sevvalmehder/RaspiJoy/Presentations/SevvalMEHDER-495-SonSunum.pdf

Bilgisayar Mühendisliği Bölümü

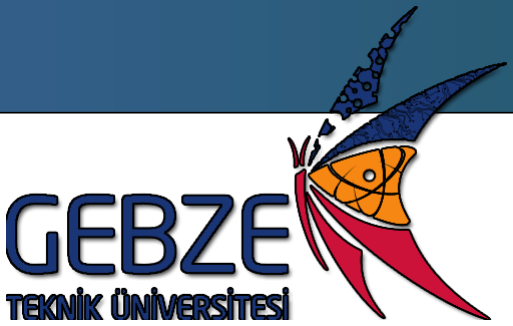
[picture p27: figure]

# RASPIJOY Uçuş Simülatörü için Kumanda

CSE 495
Son Sunum

Şevval MEHDER

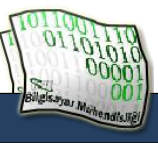
[picture p28: figure]

Proje Danışmanı: Prof. Dr. Erkan ZERGEROĞLU Ocak 2019

GTÜ - Bilgisayar Mühendisliği Bölümü | BİL 495/496 Bitirme Projesi | 2

## - Proje Tanımı

## - İzlenen Yol

## - Yapılanlar

## - Başarı Kriterlerinin Kontrolü

## - RaspiJoy’un farklı joystick olarak çalışması

## - Kaynaklar

# İçerik

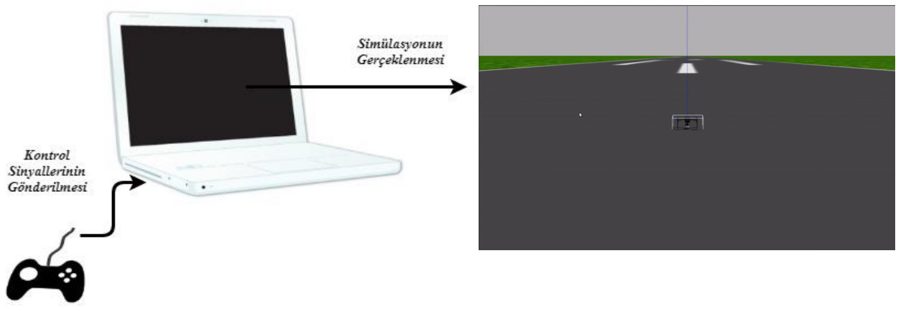
[picture p29: figure]

GTÜ - Bilgisayar Mühendisliği Bölümü | BİL 495/496 Bitirme Projesi | 3

# Proje Tanımı

Uçuş simülasyon programı SITL ve 3 boyutlu simülasyon programı Gazebo için Raspberry Pi Zero kullanılarak düşük maliyetli bir kumanda yapılması

# İzlenen yol

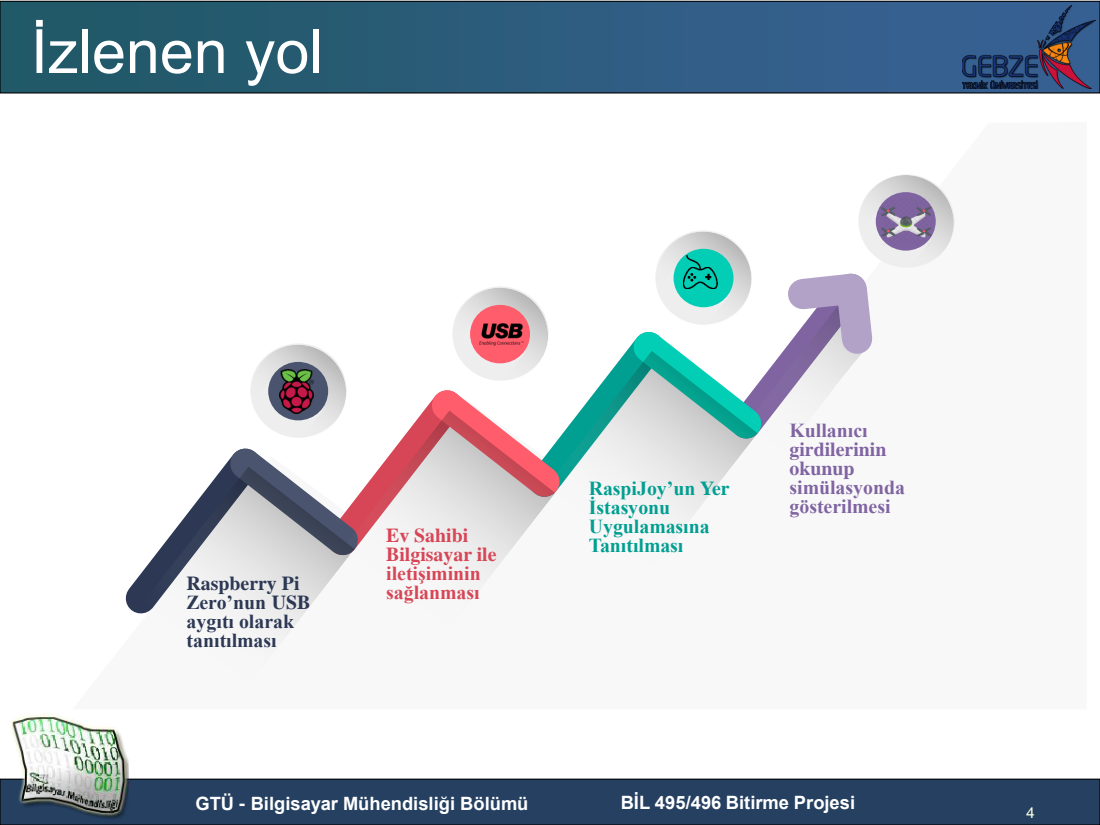
[picture p30: page 4]
GTÜ - Bilgisayar Mühendisliği Bölümü; BİL 495/496 Bitirme Projesi; Ev Sahibi Bilgisayar ile iletişiminin sağlanması; Kullanıcı girdilerinin okunup simülasyonda gösterilmesi

RaspiJoy’un Yer
İstasyonu
Uygulamasına
Tanıtılması

Raspberry Pi
Zero’nun USB
aygıtı olarak
tanıtılması

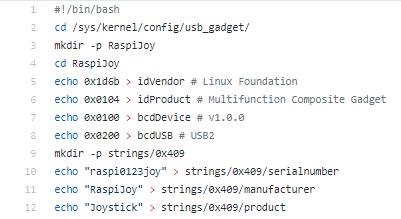
[picture p31: figure]

GTÜ - Bilgisayar Mühendisliği Bölümü | BİL 495/496 Bitirme Projesi

## Pi Zero’nun USB Aygıtı Olarak Tanıtılması

Configfs ismi verilen dosya sisteminin sağladığı arayüz sayesinde kullanıcıya özel USB aygıt tanımlaması yapıldı.

Üretici kimliği ve adı, ürünün adı, seri numarası, fonksiyonları, üreteceği bilginin türü ve boyutu gibi birçok özelliği tanımlandı.

## Pi Zero’nun USB Aygıtı Olarak Tanıtılması

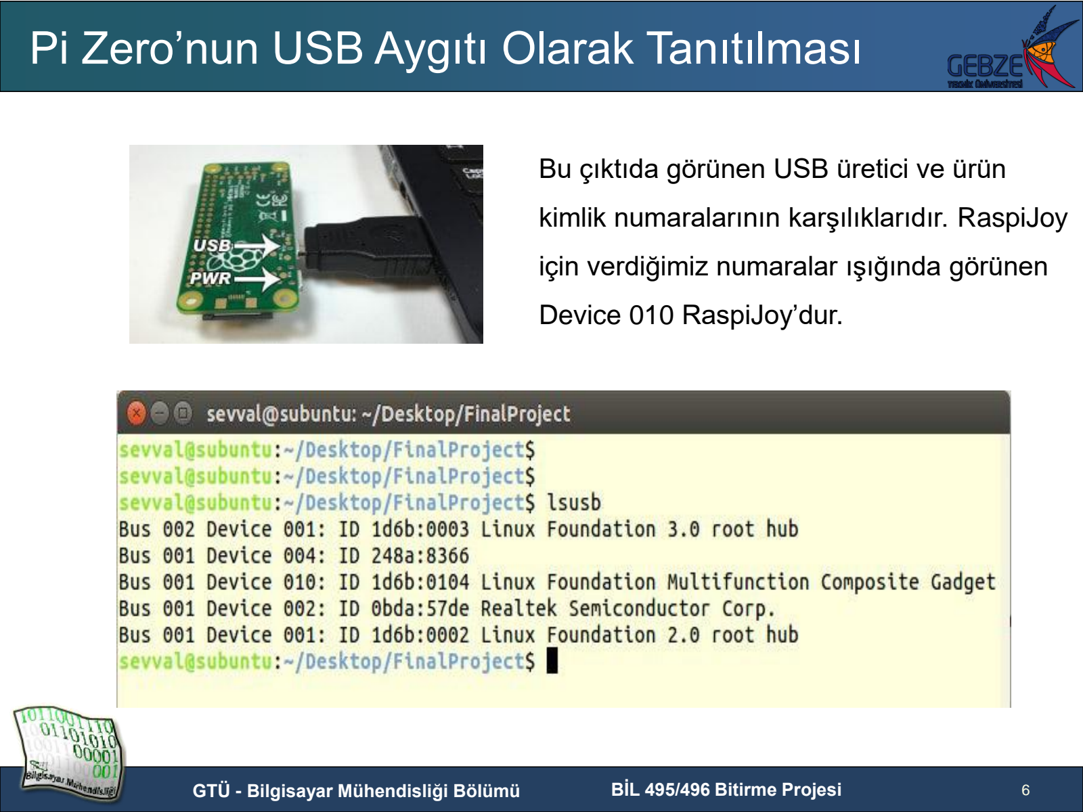
[picture p32: page 6]

6

Bu çıktıda görünen USB üretici ve ürün

kimlik numaralarının karşılıklarıdır. RaspiJoy

için verdiğimiz numaralar ışığında görünen

Device 010 RaspiJoy’dur.

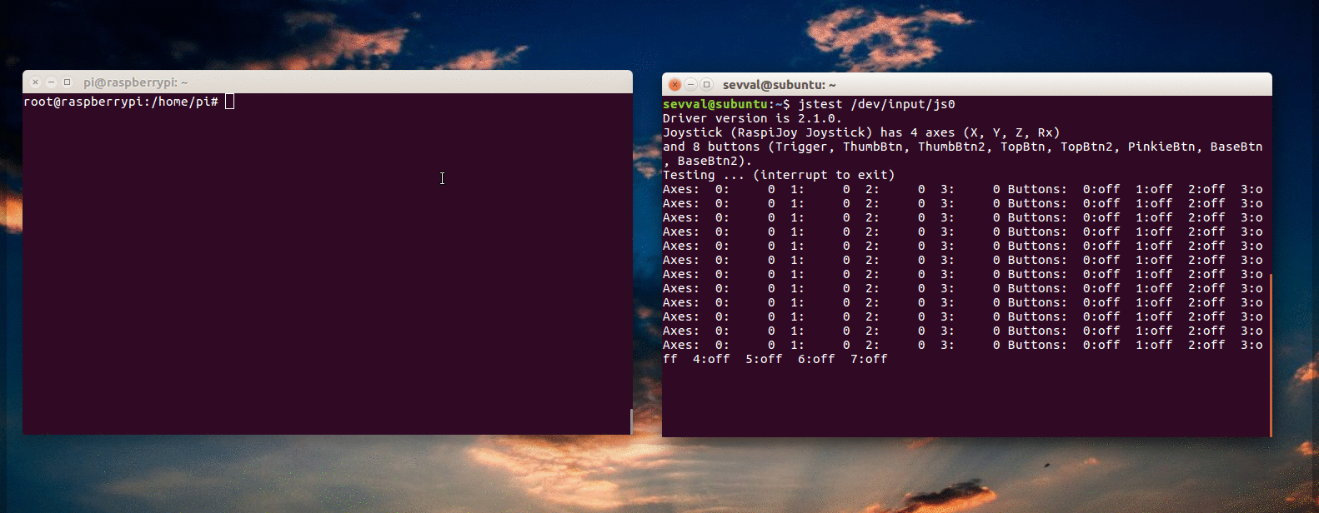
[picture p33: figure]

GTÜ - Bilgisayar Mühendisliği Bölümü | BİL 495/496 Bitirme Projesi | 7

## Ev Sahibi Bilgisayar ile İletişimin Sağlanması

RaspiJoy’un bilgisayar tarafında haberleşeceği sürücü usbhid sürücüdür. Bu sürücü Linux’un HID sınıfı aygıtlar için atadığı bir sürücüdür.

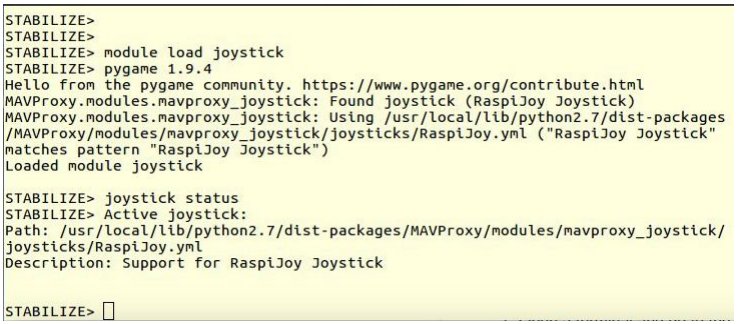
[picture p34: figure]

GTÜ - Bilgisayar Mühendisliği Bölümü | BİL 495/496 Bitirme Projesi | 8

## RaspiJoy’un Yer İstasyonu’na Tanıtılması

MAVProxy joystick modülü klasöründe MAVProxy tarafından tanınan joystick’lerin hangi hareketin simülasyonda hangi kanaldaki değeri değiştireceğinin anlatıldığı tanımları YAML formatında saklanır ve simülasyon sırasında bu tanımlar yüklenir. RaspiJoy 3 temel kontrol ile 6 kanalı kontrol eder:
1. Eksenler
2. Butonlar
3. Çoklu Buton

## Kullanıcı Girdilerinin Okunup Simülasyonda Gösterilmesi

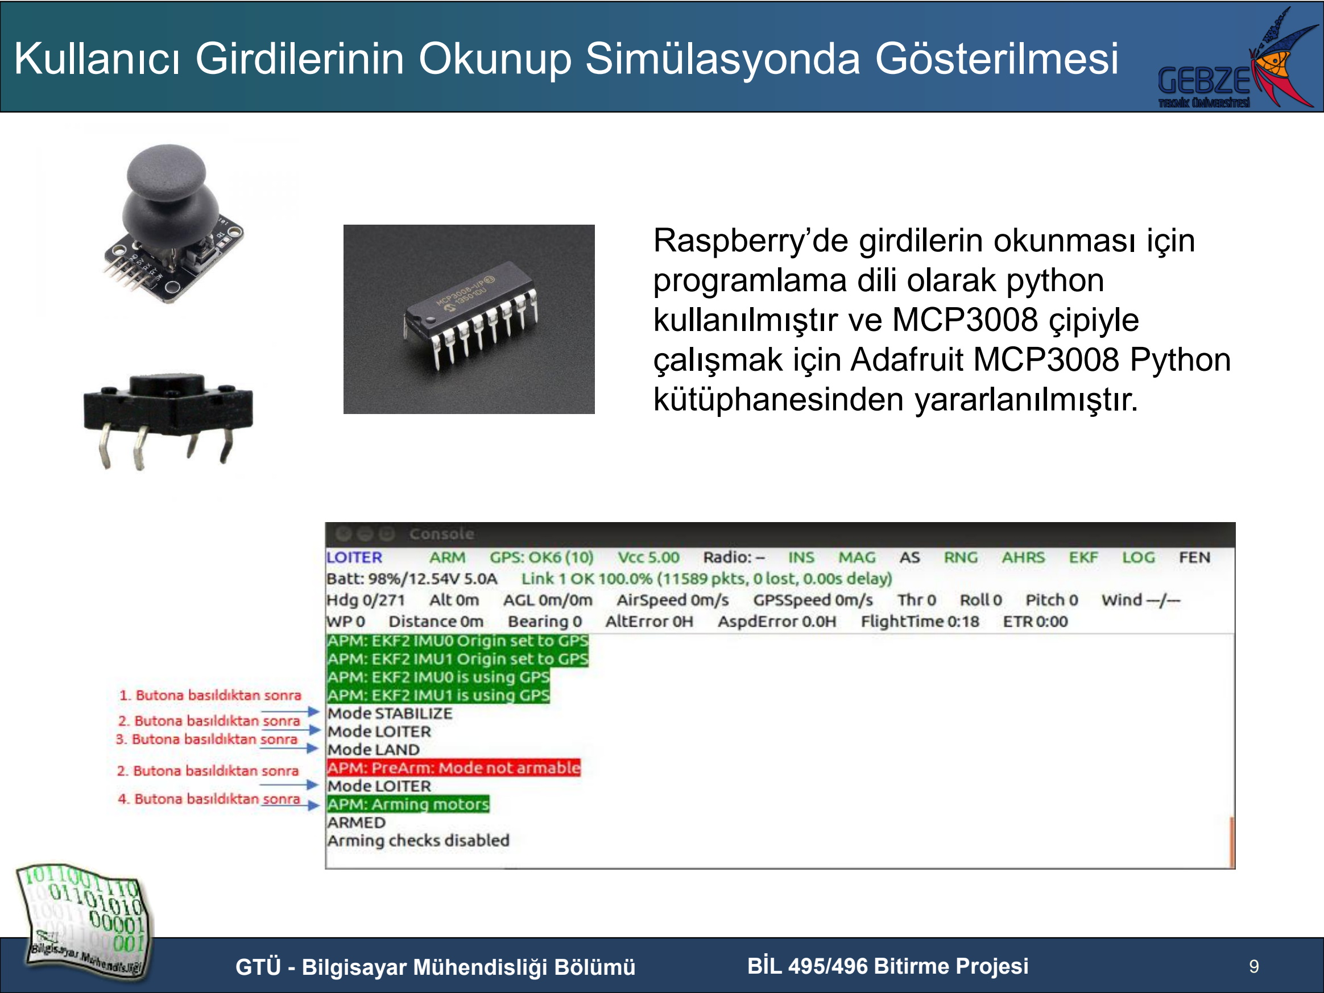
[picture p35: page 9]

GTÜ - Bilgisayar Mühendisliği Bölümü | BİL 495/496 Bitirme Projesi | 9

Raspberry’de girdilerin okunması için programlama dili olarak python kullanılmıştır ve MCP3008 çipiyle çalışmak için Adafruit MCP3008 Python kütüphanesinden yararlanılmıştır.

# Başarı Kriterlerinin Kontrolü

## Nicel gözlemler sonucu:

1. Simülasyondaki hareketin, kontrol sinyaliyle aynı olması
2. Gecikme süresi < 50 ms olması

## Nitel gözlemler sonucu:

1. Açık Kaynak Yazılım Topluluğu tarafından kabul edilebilir ve kullanılabilir olması

# Başarı Kriterlerinin Kontrolü

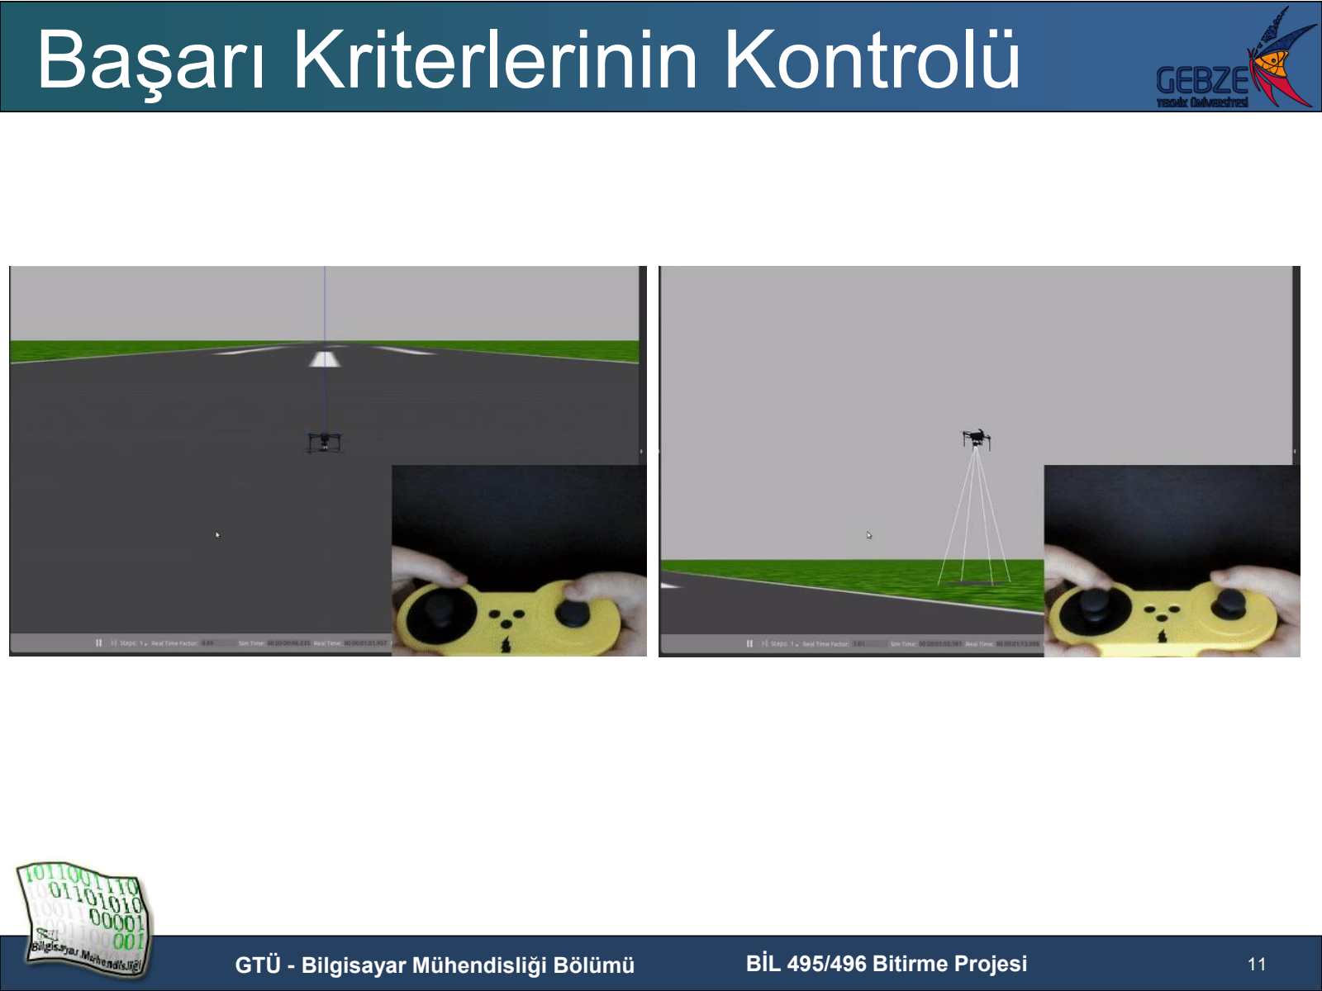
[picture p36: page 11]

GTÜ - Bilgisayar Mühendisliği Bölümü | BİL 495/496 Bitirme Projesi | 11

# Başarı Kriterlerinin Kontrolü

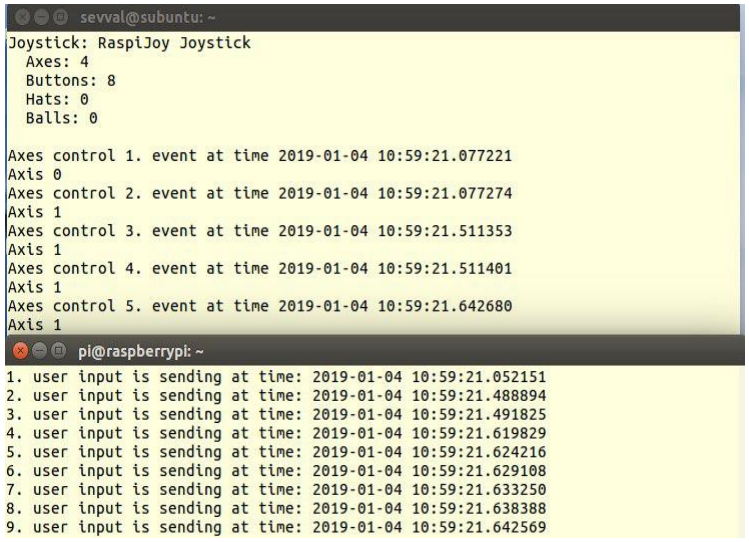
[picture p37: figure]

- Piyasadaki birçok kumanda markasındaki gecikmeleri
ölçen ve sonuçları sunan
bir yazıya göre en fazla 42 milisaniyelik bir gecikme
ölçüldüğü için başarı
kriterinde gecikmenin 50
milisaniyeden az olması
planlanmıştır.
- Farklı zamanlarda yapılan birkaç test sonucu olarak
ortalama gecikme süresi 26 milisaniyedir

## RaspiJoy’un farklı joystick olarak çalışması

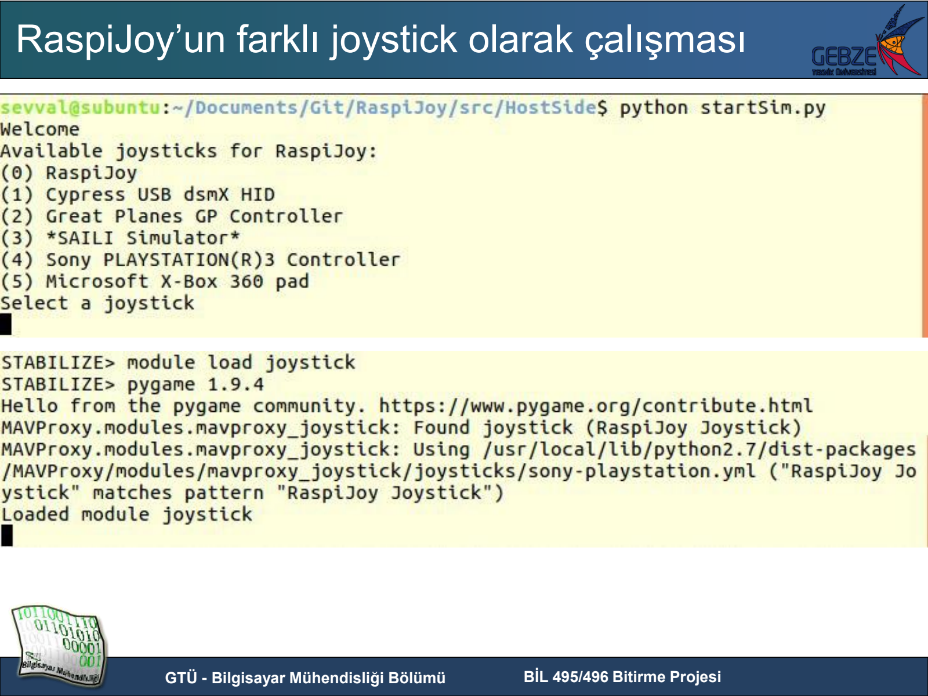
[picture p38: page 13]

## RaspiJoy’un farklı joystick olarak çalışması

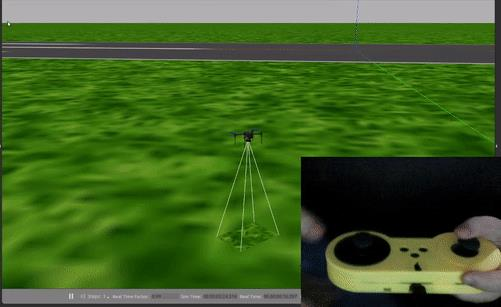
[picture p39: figure]

# Kaynaklar

1. Matt Porter Linaro, Kernel USB Gadget Configfs Interface [online], https://events.static.linuxfound.org/sites/events/files/slides/USB%20Gadget%20Configfs%20API_0.pdf (https://events.static.linuxfound.org/sites/events/files/slides/USB%20Gadget%20Configfs%20API_0.pdf)
2. Microsoft Word - HID1_11.doc [online], https://www.usb.org/sites/default/files/documents/hid1_11.pdf. [Ziyaret Tarihi: 23
Kasım 2018]
3. Arcade Stick Input Lag – Results [online], http://www.teyah.net/sticklag/results.html
4. ArduPilot Copter Home[online], http://ardupilot.org/copter/

15
