sevvalmehder/RaspiJoy/Presentations/SevvalMEHDER-495-İkinciİzleme.pdf

Bilgisayar Mühendisliği Bölümü

# Uçuş Simülatörü için Joystick Arayüzü

## BIL 495 2. İzleme

## Şevval MEHDER


## Proje Danışmanı: Prof. Dr. Erkan ZERGEROĞLU

## Aralık 2018

GTÜ - Bilgisayar Mühendisliği Bölümü | BİL 495/496 Bitirme Projesi | 2

# - Projenin Şeması ve Tanımı

# - Proje Tasarım Planı

# - Yapılanlar

# - Yapılacaklar

# - Kaynaklar

# İçerik

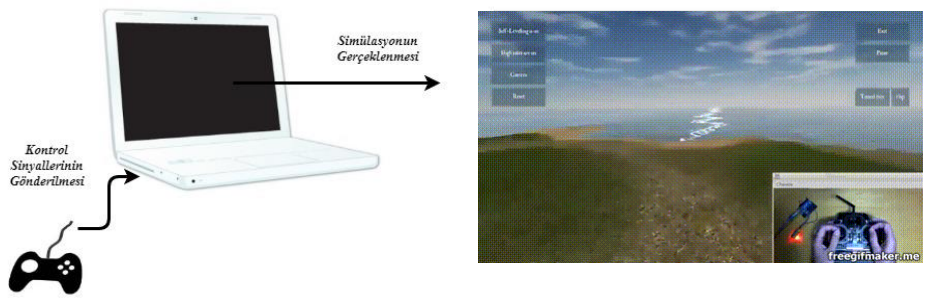
[picture p40: figure]

GTÜ - Bilgisayar Mühendisliği Bölümü | BİL 495/496 Bitirme Projesi | 3

# Proje Şeması ve Tanımı

## − ArduPilot Simülasyon Programı için bir joystick

donanımı ve arayüz hazırlanması.

# Yapılanlar

Raspberry Pi Zero’nun USB aygıtı olarak tanınması desteği sağlandı.

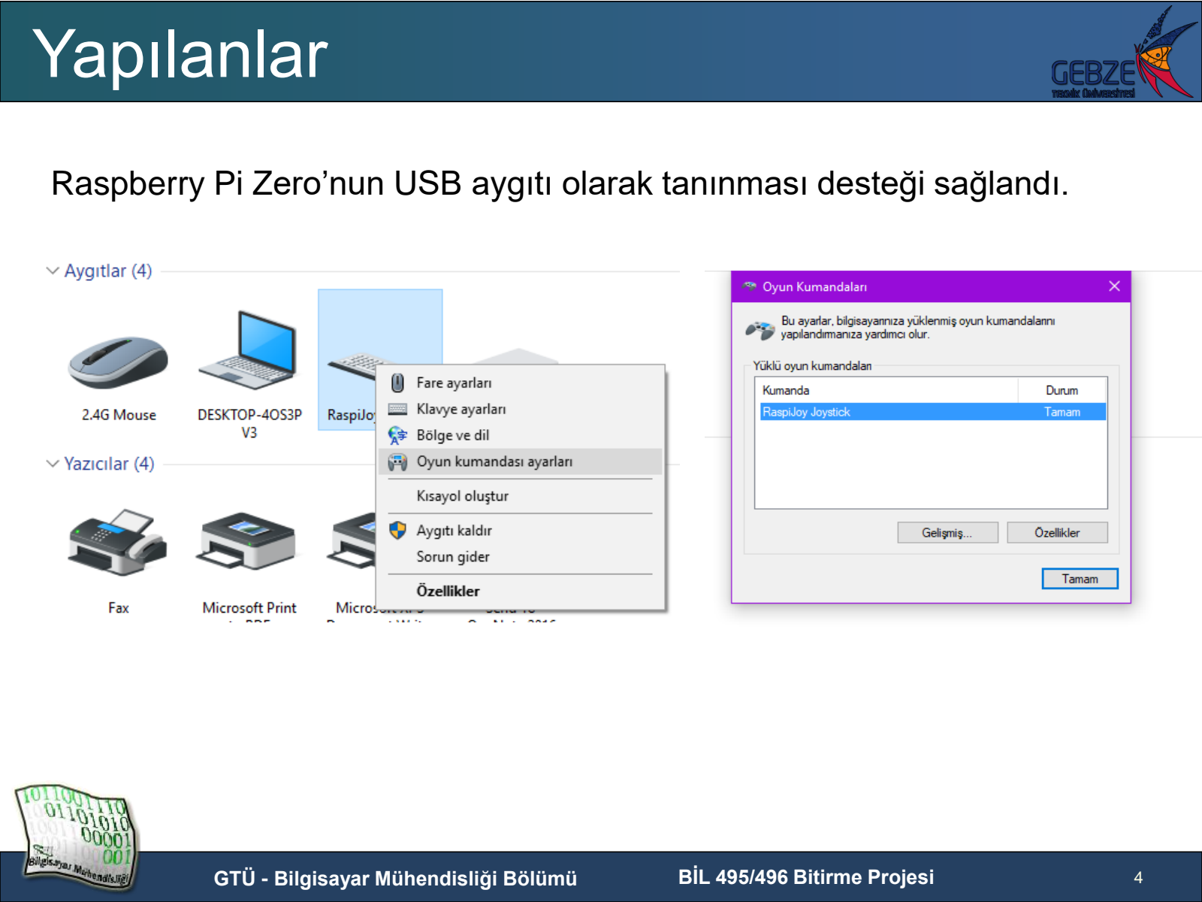
[picture p41: page 4]

GTÜ - Bilgisayar Mühendisliği Bölümü | BİL 495/496 Bitirme Projesi | 4

# Yapılanlar

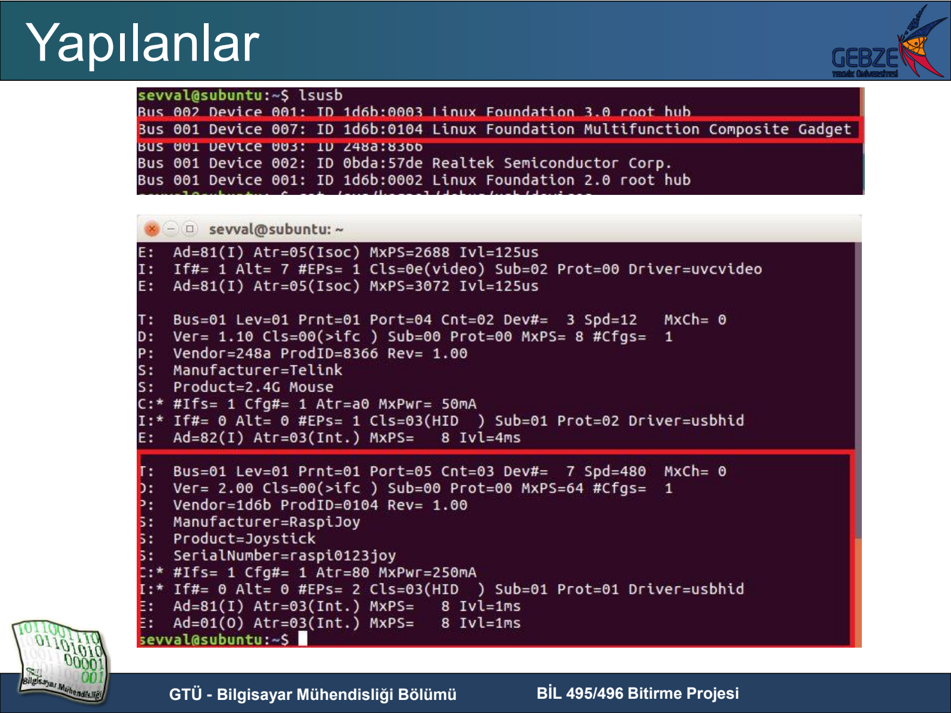
[picture p42: page 5]

GTÜ - Bilgisayar Mühendisliği Bölümü | BİL 495/496 Bitirme Projesi

# Yapılanlar

# USB konfigürasyon dosyasının yazılması

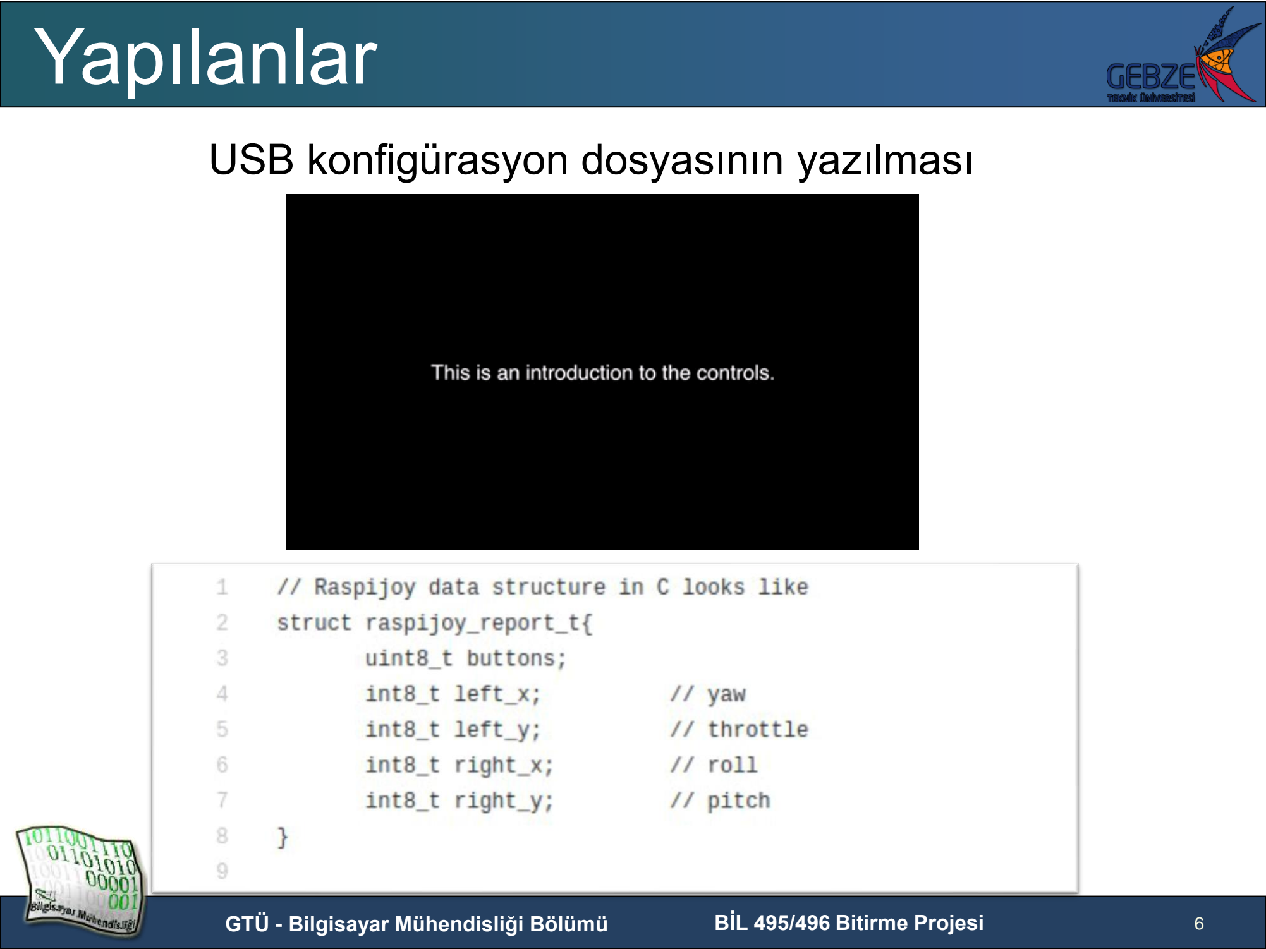
[picture p43: page 6]

GTÜ - Bilgisayar Mühendisliği Bölümü | BİL 495/496 Bitirme Projesi
6

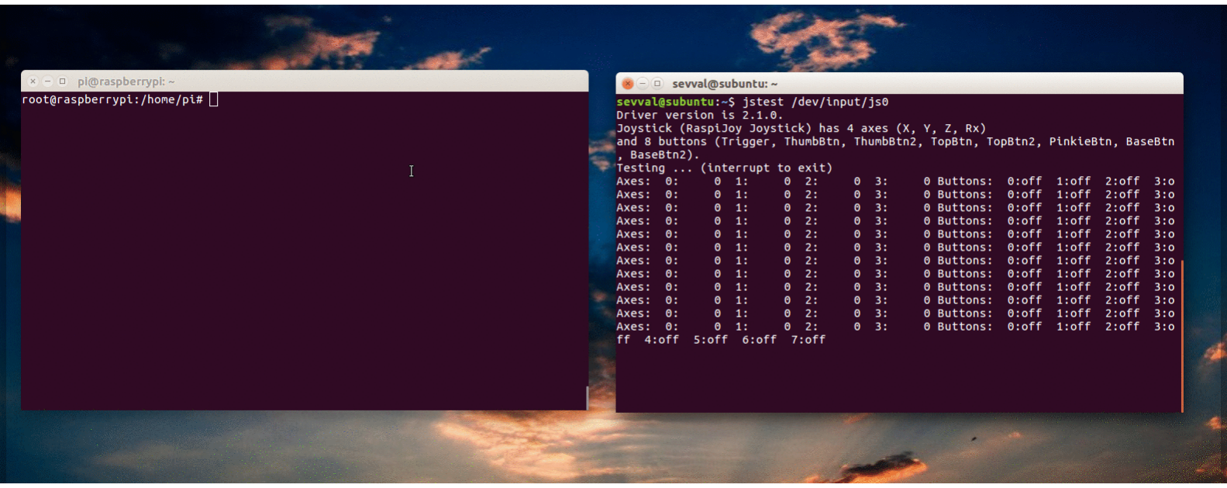
[picture p44: figure]

GTÜ - Bilgisayar Mühendisliği Bölümü | BİL 495/496 Bitirme Projesi | 7

# Yapılanlar

## Bilgisayara veri gönderilmesinin sağlanması

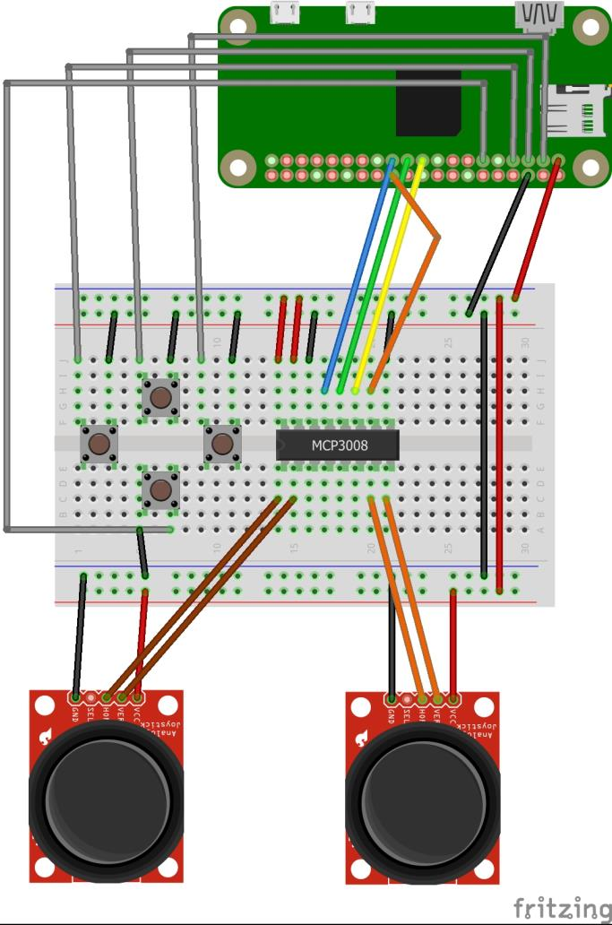
[picture p45: figure]

GTÜ - Bilgisayar Mühendisliği Bölümü | BİL 495/496 Bitirme Projesi | 8

# Yapılanlar

## Analog joystick modüllerinin ADC(MCP3008 chip) yardımıyla Raspberry’e bağlanması

# Yapılanlar

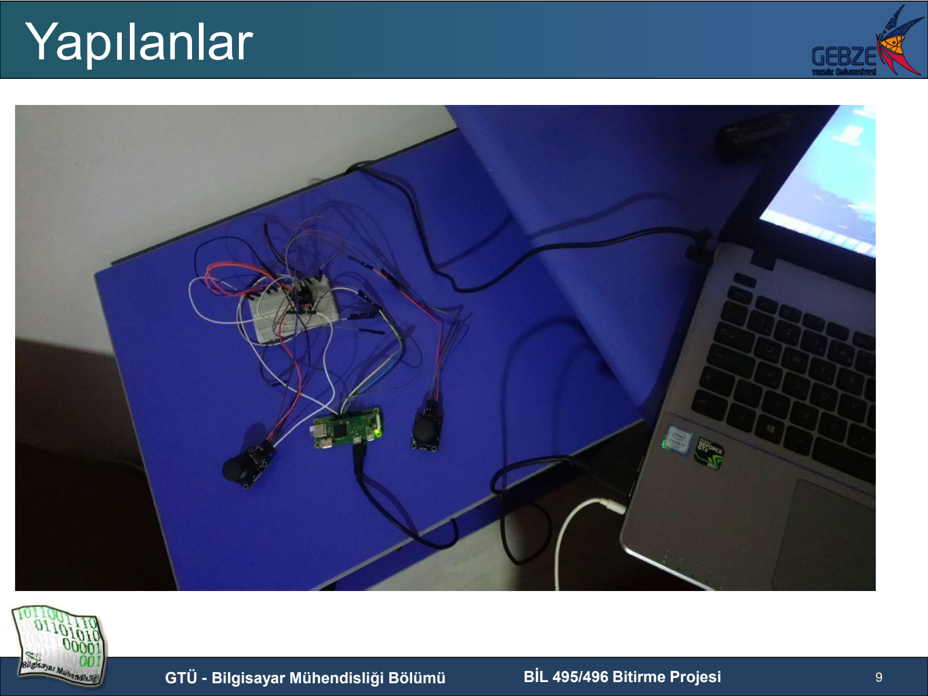
[picture p46: page 9]

GTÜ - Bilgisayar Mühendisliği Bölümü | BİL 495/496 Bitirme Projesi | 9

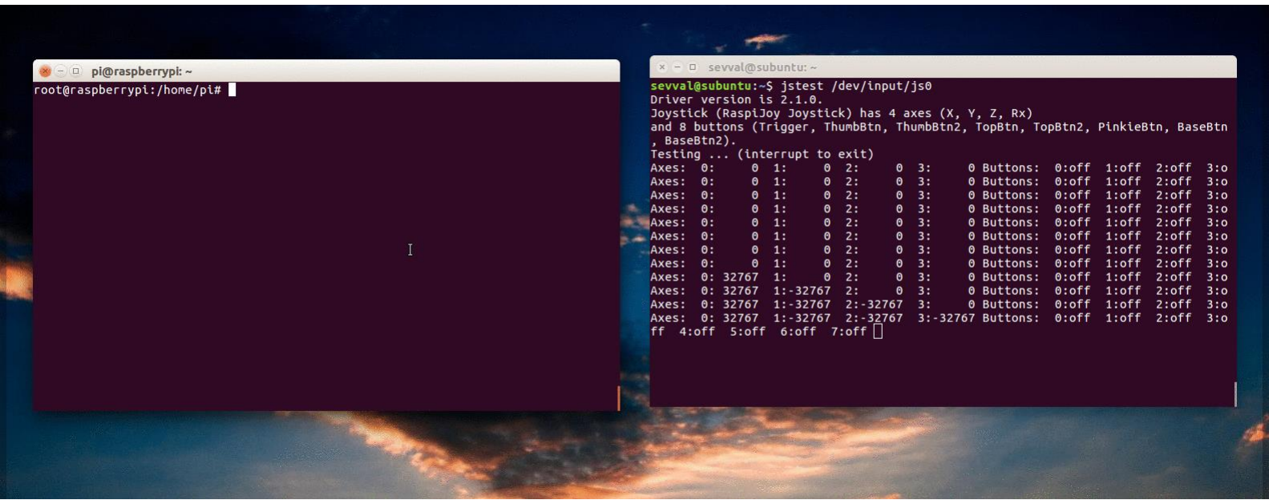
[picture p47: figure]

GTÜ - Bilgisayar Mühendisliği Bölümü | BİL 495/496 Bitirme Projesi | 10

# Yapılanlar

## Joystick modüllerinden gelen bilginin bilgisayara gönderilmesi

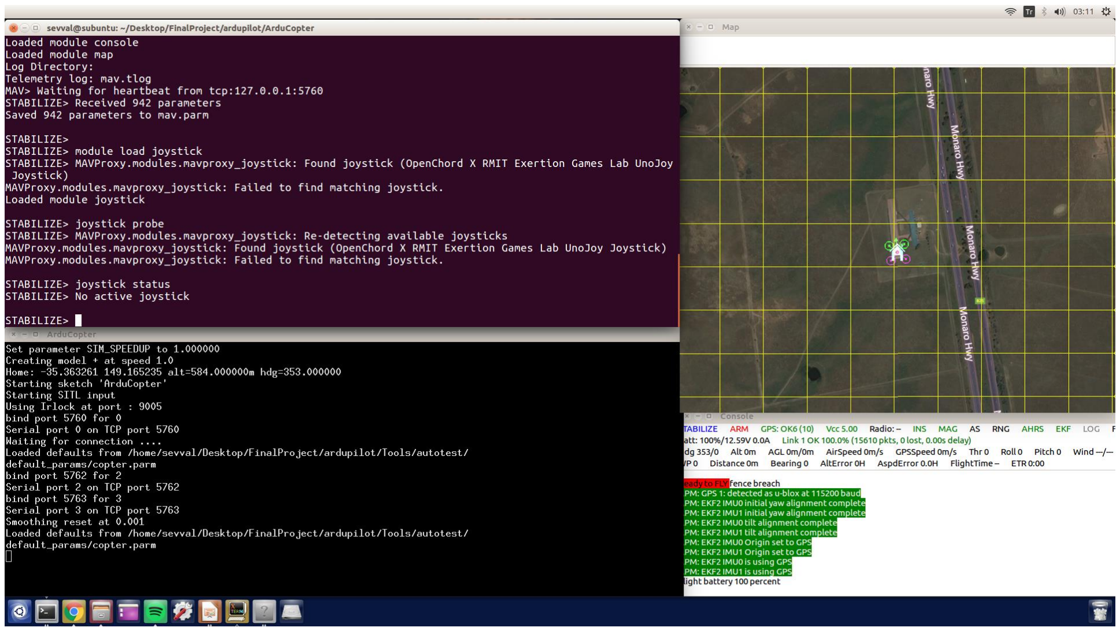
[picture p48: figure]

GTÜ - Bilgisayar Mühendisliği Bölümü | BİL 495/496 Bitirme Projesi | 11

# Yapılanlar

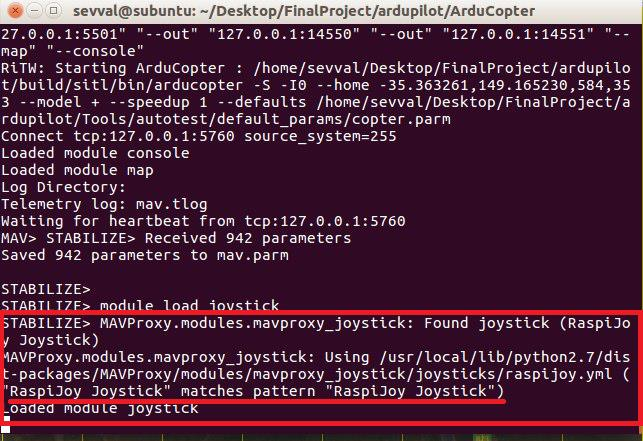
[picture p49: figure]

GTÜ - Bilgisayar Mühendisliği Bölümü | BİL 495/496 Bitirme Projesi | 12

# Yapılanlar

## Bilgisayar tarafından tanınan joystick’in MAVProxy yer istasyonu tarafından da tanınmasının sağlanması

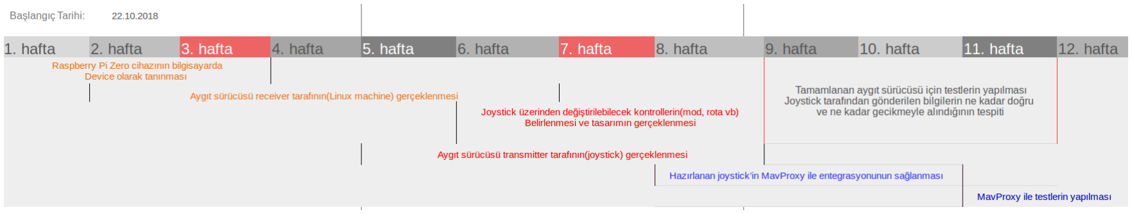
[picture p50: figure]

GTÜ - Bilgisayar Mühendisliği Bölümü | BİL 495/496 Bitirme Projesi | 13

# Yapılacaklar

## - Doğru joystick bilgilerinin alınması - Gecikme değerlerinin ölçülmesi - Simülasyonda doğru sinyallerin doğru hareketi gerçekleştirmesinin sağlanması

GTÜ - Bilgisayar Mühendisliği Bölümü | BİL 495/496 Bitirme Projesi

# Kaynaklar

# 1. Joystickle uçuş demosu ve detaylı bilgi: https://myfirstdrone.com/how-to-fly-a-quadcopter

14
