sevvalmehder/RaspiJoy/Presentations/SevvalMEHDER-495-İlkİzleme.pdf

Bilgisayar Mühendisliği Bölümü

# Uçuş Simülatörü için Joystick Arayüzü

## BIL 495 1. İzleme

## Şevval MEHDER


## Proje Danışmanı: Prof. Dr. Erkan ZERGEROĞLU

## Kasım 2018

GTÜ - Bilgisayar Mühendisliği Bölümü | BİL 495/496 Bitirme Projesi | 2

# - Projenin Şeması ve Tanımı

# - Proje Tasarım Planı

# - Proje Gereksinimleri

# - Başarı Kriterleri

•

# - Kaynaklar

# İçerik


GTÜ - Bilgisayar Mühendisliği Bölümü | BİL 495/496 Bitirme Projesi | 3

# Proje Şeması ve Tanımı

## − ArduPilot Simülasyon Programı için bir joystick

donanımı ve arayüz hazırlanması.

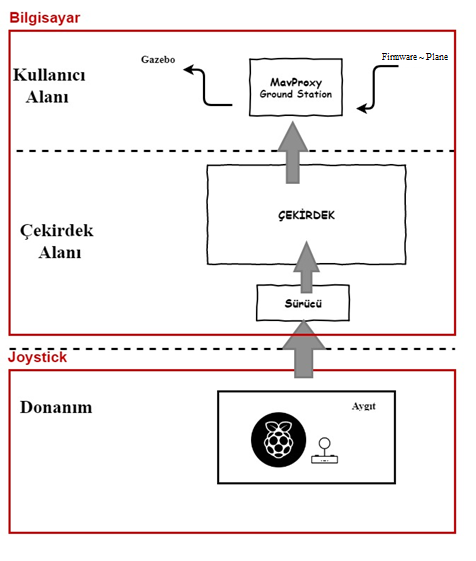
[picture p51: figure]

GTÜ - Bilgisayar Mühendisliği Bölümü | BİL 495/496 Bitirme Projesi | 4

# Proje Tasarım Planı

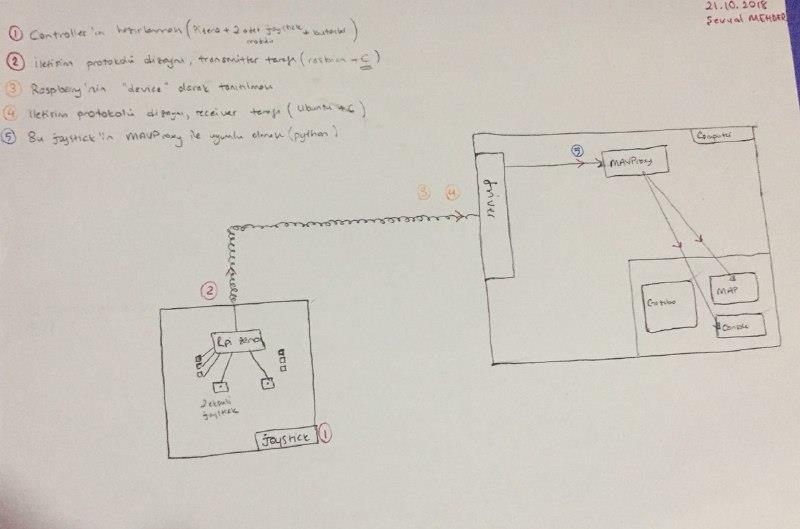
[picture p52: figure]

GTÜ - Bilgisayar Mühendisliği Bölümü | BİL 495/496 Bitirme Projesi | 5

# Yapılanlar

- Süreç(process) ve enstrümantal(instrumental) diyagram çıkarıldı.

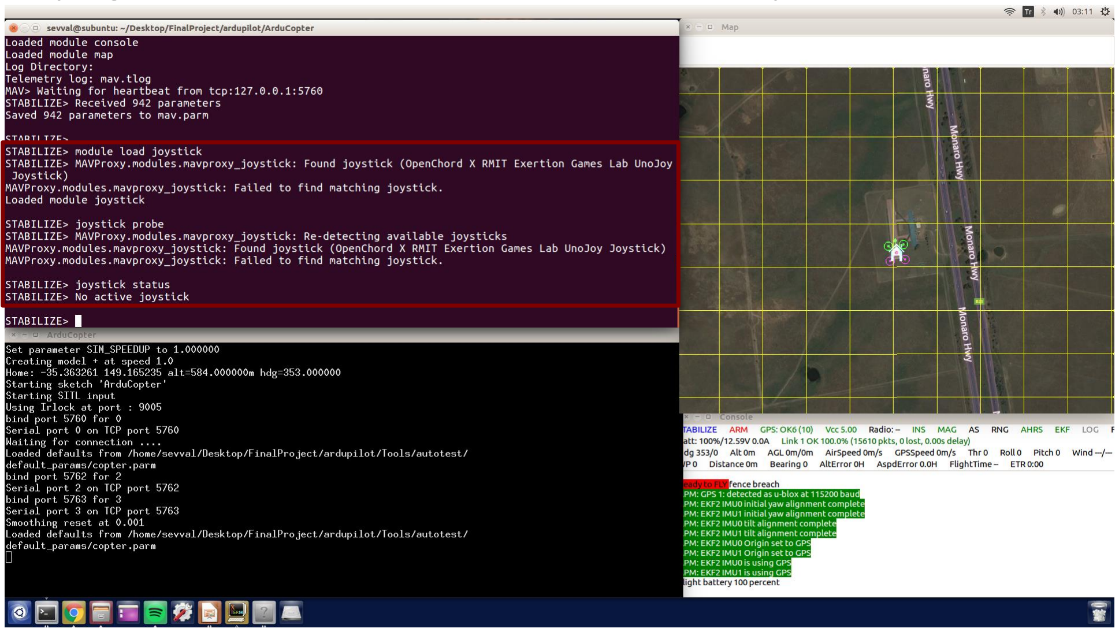
[picture p53: figure]

GTÜ - Bilgisayar Mühendisliği Bölümü | BİL 495/496 Bitirme Projesi

# Yapılanlar

# - Diyagramdaki 5. maddenin başka bir yolla denenmesi

6

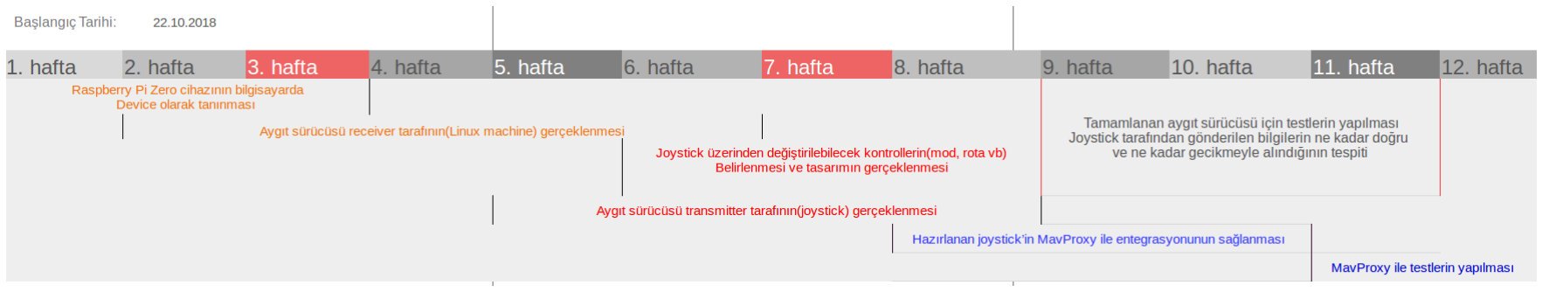
[picture p54: figure]

GTÜ - Bilgisayar Mühendisliği Bölümü | BİL 495/496 Bitirme Projesi | 7

# Yapılanlar

## - İş planının hazırlanması

# Yapılanlar

## - Driver kısmındaki görevlere başlanması:

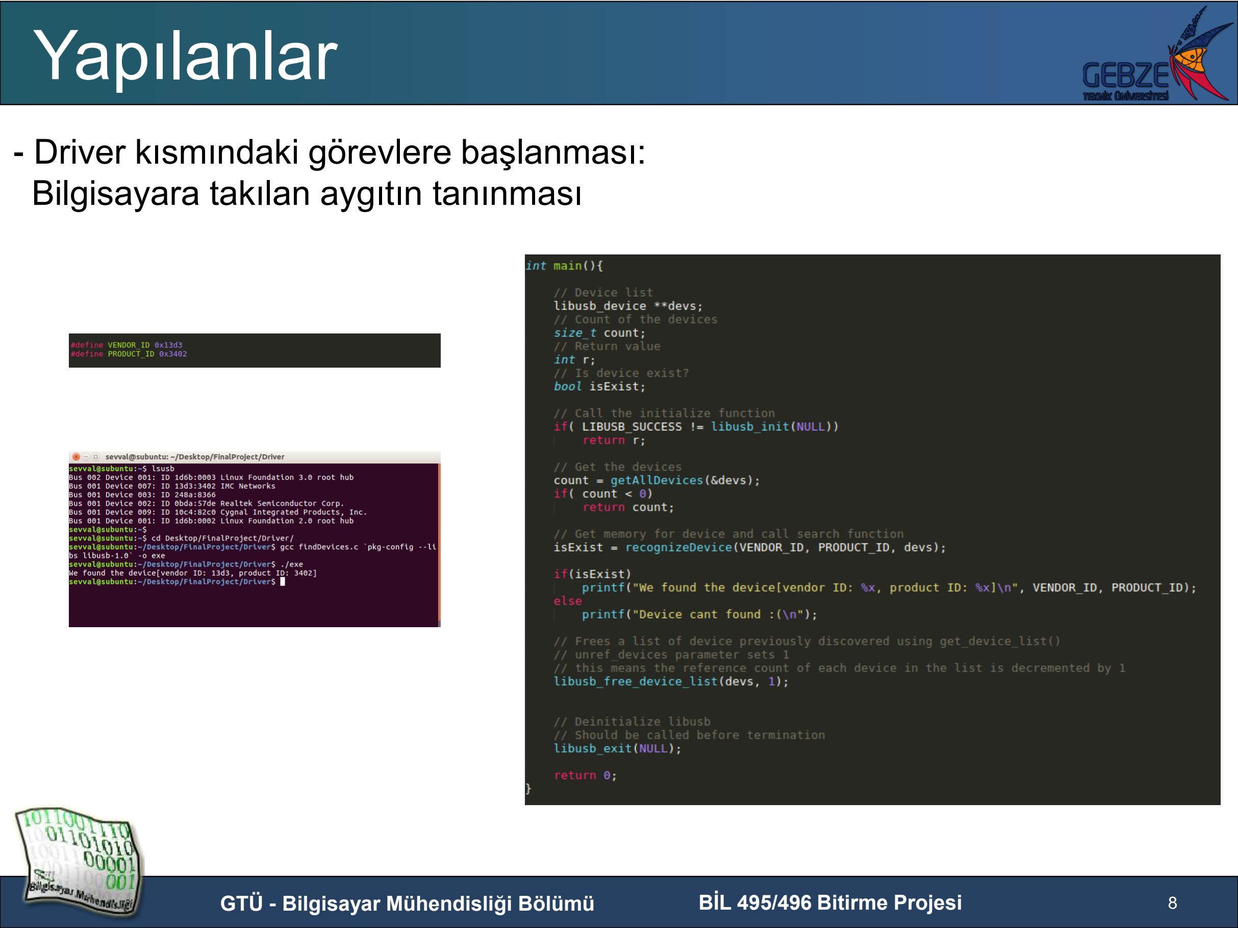
[picture p55: page 8]

GTÜ - Bilgisayar Mühendisliği Bölümü | BİL 495/496 Bitirme Projesi | 8

## Bilgisayara takılan aygıtın tanınması

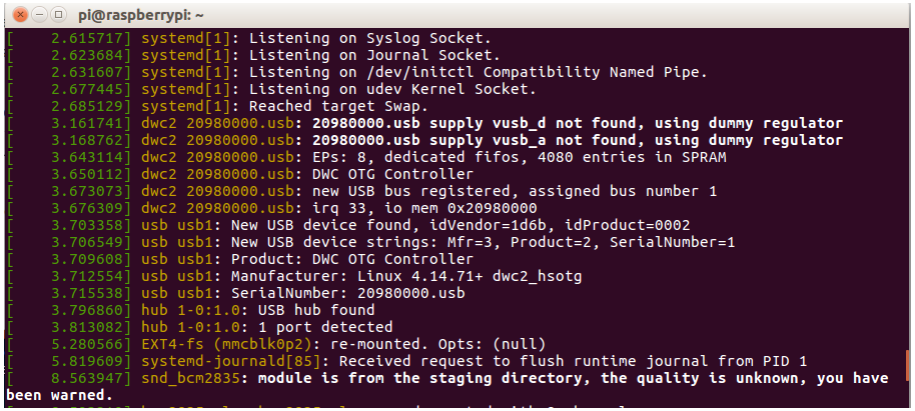
[picture p56: figure]

GTÜ - Bilgisayar Mühendisliği Bölümü | BİL 495/496 Bitirme Projesi

# Denenenler

# - Raspberry'nin device olarak tanıtılması

9

GTÜ - Bilgisayar Mühendisliği Bölümü | BİL 495/496 Bitirme Projesi

# Kaynaklar

- 1. Libusb API: http://libusb.sourceforge.net/api-1.0/ (http://libusb.sourceforge.net/api-1.0/) - 2. RPi Zero USB aygıt desteği hakkındaki pull requst: https://github.com/raspberrypi/linux/iss ues/1212 (https://github.com/raspberrypi/linux/issues/1212) - 3. RPi Zero USB aygıt desteği hakkında adafruit dökümanı: https://cdnlearn.adafruit.com/downloads/pdf/turning-yourraspberry-pi-zero-into-a-usb-gadget.pdf - 4. MavProxy joystick modülü yüklenmesi: https://ardupilot.github.io/MAVPro

xy/html/modules/joystick.html (https://ardupilot.github.io/MAVProxy/html/modules/joystick.html)

10
