sevvalmehder/RaspiJoy/Connection Design/connection.jpg

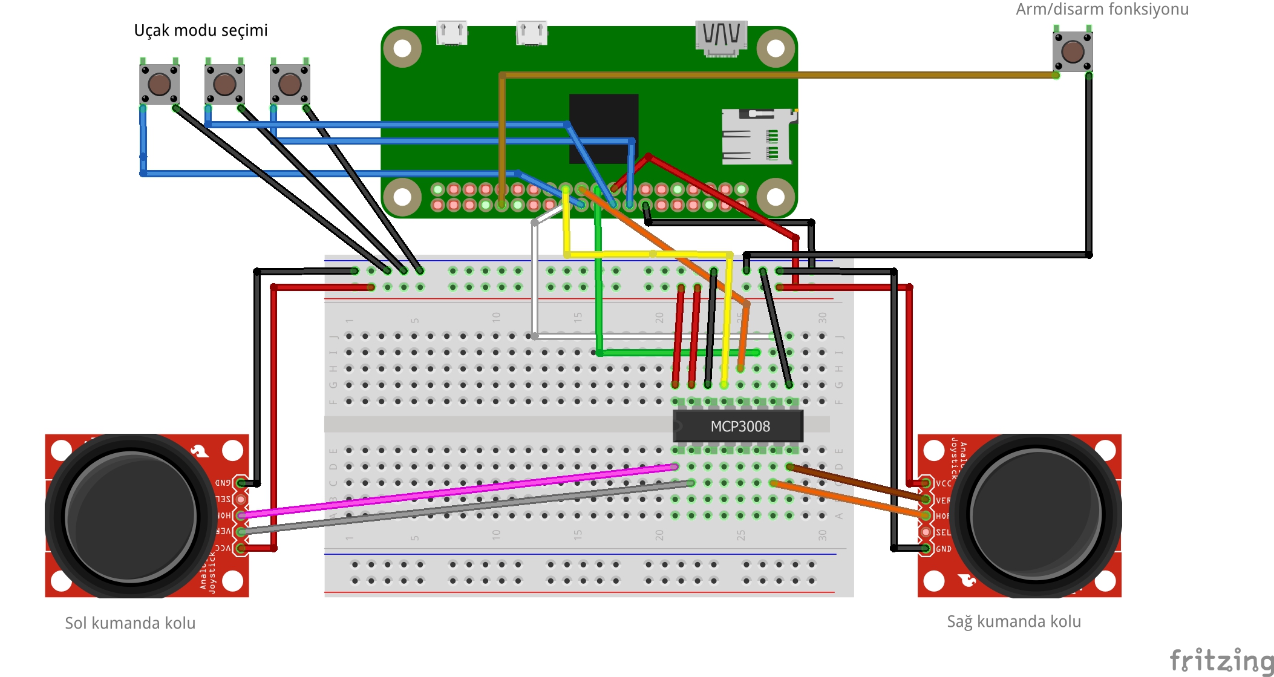
Connection Design/connection.jpg
