sevvalmehder/RaspiJoy/Connection Design/MCP3008.png

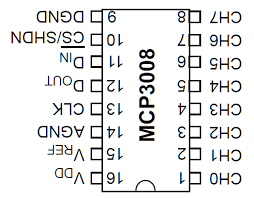
Connection Design/MCP3008.png
