sevvalmehder/RaspiJoy/(list of files, drawings)

Other design files:
Connection Design/connection.fzz
