sevvalmehder/RaspiJoy/(commit log)

2018-12-03 Added joystick connection circuit design
    [connection.fzz]
2018-12-05 Wired problem correction
    [connection.fzz]
2018-12-05 Buttons added
    [connection.fzz]
2018-12-06 Correction of button wiring
    [connection.fzz]
2018-12-06 Rotate the circuit
    [connection.fzz]
2018-12-06 Connection of buttons added
2018-12-06 Correction of button error
    [connect.py]
2018-12-08 Some changes for design
    [connection.fzz]
2018-12-08 Design changes in repo
    [connection.fzz]
2018-12-30 Buttons informations were added
2018-12-31 Button was added for arm/disarm
2018-12-31 Additional information about button
2018-12-31 New connection design
    [connection.fzz]
2019-01-12 Fix: Button error
